Ecdysiasttt/com3505-iot/LA2/ProjectThing/src/config.h

// WiFi credentials
// #include <marvin-private.h>

// are you using an I2S microphone - comment this out if you want to use an analog mic and ADC input
// #define USE_I2S_MIC_INPUT

// I2S Microphone Settings

// Which channel is the I2S microphone on? I2S_CHANNEL_FMT_ONLY_LEFT or I2S_CHANNEL_FMT_ONLY_RIGHT
// #define I2S_MIC_CHANNEL I2S_CHANNEL_FMT_ONLY_LEFT
// #define I2S_MIC_CHANNEL I2S_CHANNEL_FMT_ONLY_RIGHT
/*
#define I2S_MIC_SERIAL_CLOCK GPIO_NUM_33
#define I2S_MIC_LEFT_RIGHT_CLOCK GPIO_NUM_26
#define I2S_MIC_SERIAL_DATA GPIO_NUM_25
*/

//#ifdef UNPHONE_SPIN
// #define I2S_MIC_SERIAL_CLOCK GPIO_NUM_32
//#else
//#endif


//#ifdef UNPHONE_SPIN
// #define I2S_MIC_SERIAL_DATA GPIO_NUM_33
//#else
//#endif

// old pinouts, changed to allow for e-ink feather
  // #define I2S_MIC_SERIAL_CLOCK GPIO_NUM_13
  // #define I2S_MIC_LEFT_RIGHT_CLOCK GPIO_NUM_15
  // #define I2S_MIC_SERIAL_DATA GPIO_NUM_21

// #define I2S_MIC_LEFT_RIGHT_CLOCK GPIO_NUM_13
// #define I2S_MIC_SERIAL_DATA GPIO_NUM_12
// #define I2S_MIC_SERIAL_CLOCK GPIO_NUM_27

// #define I2S_MIC_LEFT_RIGHT_CLOCK GPIO_NUM_16
// #define I2S_MIC_SERIAL_DATA GPIO_NUM_17
// #define I2S_MIC_SERIAL_CLOCK GPIO_NUM_21

// Analog Microphone Settings - ADC1_CHANNEL_7 is GPIO35
// #define ADC_MIC_CHANNEL ADC1_CHANNEL_7

// speaker settings
/*
#define I2S_SPEAKER_LEFT_RIGHT_CLOCK GPIO_NUM_12
#define I2S_SPEAKER_SERIAL_CLOCK GPIO_NUM_14
#define I2S_SPEAKER_SERIAL_DATA GPIO_NUM_27
// */
// #define I2S_SPEAKER_LEFT_RIGHT_CLOCK GPIO_NUM_21
// #define I2S_SPEAKER_SERIAL_CLOCK GPIO_NUM_21
// #define I2S_SPEAKER_SERIAL_DATA GPIO_NUM_17
// old pinouts, changed to allow for e-ink feather
  // #define I2S_SPEAKER_LEFT_RIGHT_CLOCK GPIO_NUM_12
  // #define I2S_SPEAKER_SERIAL_CLOCK GPIO_NUM_14
  // #define I2S_SPEAKER_SERIAL_DATA GPIO_NUM_27


// command recognition settings
// server access token
// #define COMMAND_RECOGNITION_ACCESS_KEY "FYNEKCN6DS7E63IT7DLS57O7X25VJSWZ"

// #define LED_KITCHEN_PIN GPIO_NUM_4
// #define LED_BEDROOM_PIN GPIO_NUM_26
// #define LED_TABLE_PIN GPIO_NUM_25

////////////////////////
// NEW SETTINGS
////////////////////////

// =============================== MIC ===============================
// Are you using an I2S microphone - comment this out if you want to use an analog mic and ADC input
#define USE_I2S_MIC_INPUT

// Pinouts
#define I2S_MIC_LEFT_RIGHT_CLOCK GPIO_NUM_16
#define I2S_MIC_SERIAL_DATA GPIO_NUM_17
#define I2S_MIC_SERIAL_CLOCK GPIO_NUM_21

// Analog Microphone Settings - ADC1_CHANNEL_7 is GPIO35
#define ADC_MIC_CHANNEL ADC1_CHANNEL_7

// Which channel is the I2S microphone on? I2S_CHANNEL_FMT_ONLY_LEFT or I2S_CHANNEL_FMT_ONLY_RIGHT
#define I2S_MIC_CHANNEL I2S_CHANNEL_FMT_ONLY_LEFT


// ============================= SPEAKER =============================
// == !!         NOT IN USE         !! ==
#define I2S_SPEAKER_LEFT_RIGHT_CLOCK -1
#define I2S_SPEAKER_SERIAL_CLOCK -1
#define I2S_SPEAKER_SERIAL_DATA -1

// ============================ INDICATOR ============================
// == !!     INSTEAD OF SPEAKER     !! ==
#define INDICATOR_LED_PIN GPIO_NUM_23

// ============================== E-INK ==============================
// Pinouts
#define EPD_DC GPIO_NUM_33
#define EPD_CS GPIO_NUM_15       
#define SRAM_CS GPIO_NUM_32 //SRAM Chip Select - communicates with onboard ram
// #define EPD_SPI &SPI
#define EPD_RESET GPIO_NUM_NC
#define EPD_BUSY GPIO_NUM_NC

// Colours
#define COLOR1 EPD_BLACK
#define COLOR2 EPD_RED
#define WHITE EPD_WHITE
#define BLACK EPD_BLACK


// ============================= WIT.AI ==============================
// Server access token
#define COMMAND_RECOGNITION_ACCESS_KEY "FYNEKCN6DS7E63IT7DLS57O7X25VJSWZ"
