Ecdysiasttt/com3505-iot/sketch/Ex08.cpp

// Ex08.cpp/.ino
// become a web client and send your email to our cloud server over HTTPS

#include "Thing.h"

// globals and utilities for connecting to COM3505 cloud server
WiFiClientSecure com3505Client; // the TLS web client
const char *com3505Addr   = "SERVER IP ADDRESS"; // server IP (see blackboard)
const int   com3505Port   = 9194;                // server port
const char* wifiSsid      = "CHANGE_ME";         // wifi AP for ESP to connect
const char* wifiPassword  = "CHANGE_ME_TOO";     // wifi PSK
const char* myEmail       = "AND_CHANGE_ME_AS_WELL@sheffield.ac.uk";// yr email

// x509 certificate for the server
const char* cert = \
  "-----BEGIN CERTIFICATE-----\n" \
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
  "PQ0ptJ0=" \
  "-----END CERTIFICATE-----\n";


void setup08() {
  setup07(); dln(startupDBG, "\nsetup08...");

  // a URI for the request
  String url;
  url = "/com3505-2024?email=";
  url += myEmail;
  url += "&mac=";
  url += MAC_ADDRESS;

  // conect to the uni network
  // (if your device is already provisioned you can use "WiFi.begin();" here)
  dbg(netDBG, "connecting to wifi...");
//  WiFi.begin();
  WiFi.begin(wifiSsid, wifiPassword);
  while(WiFi.status() != WL_CONNECTED) {
    delay(500);
    dbg(netDBG, ".");
  }

  dbg(netDBG, "wifi connected; IP address: ");
  dln(netDBG, WiFi.localIP());

  // now we'll try and talk to the "cloud" server; this is
  // in setup instead of loop so we don't send too much data to the server...
  //
  // first connect to the cloud server or reset after pause
  if(! cloudConnect()) {
    Serial.println("** OOOPS! no connection to server; restarting in 10 **");
    delay(10000);
    ESP.restart();
  }
    
  // send the request to the server
  cloudGet(url);

  // read all the lines of the reply from server and print to serial
  while(cloudAvailable()) dbg(netDBG, cloudRead());

  // job's a goodun
  dln(netDBG, "closing connection...");
  cloudStop();
} // setup08()

void loop08() {
  // serve pending web requests
  webServer.handleClient();
} // loop08()

// use WiFiClient class to create TCP connection to cloud
bool cloudConnect() {
  dbg(netDBG, "\nconnecting to ");
  dbg(netDBG, com3505Addr);
  dbg(netDBG, ":");
  dln(netDBG, com3505Port);

  // configure the TLS client for connection; ordinarily we would do
  // "setCACert(...)" but the server is using a self-signed certificate so the
  // CA chain doesn't exist; instead we just give the client certificate and
  // do "setInsecure" - the connection should still be encrypted, but more
  // vulnerable to a MitM attack
  com3505Client.setCertificate(cert); // client verification only
  // setInsecure doesn't exist in some of the Arduino core versions that we
  // may be using, so this is commented here; try uncommenting, and see the
  // notes: https://iot.unphone.net/#patch-the-core-for-ex08
  com3505Client.setInsecure(); // tell mbedTLS to ignore the CA chain

  // open the connection, or punt
  if(com3505Client.connect(com3505Addr, com3505Port)) {
    dln(netDBG, "connected to com3505 server; doing GET");
  } else {
    dbg(netDBG, com3505Addr);
    dln(netDBG, " - no com3505 server");
    return false;
  }
  return true;
} // cloudConnect()

// do a GET request on com3505Client
void cloudGet(String url) {
  dbg(netDBG, "requesting URL: ");
  dln(netDBG, url);
  com3505Client.print(
    String("GET ") + url + " HTTP/1.1\r\n" +
    "Host: " + com3505Addr + "\r\n" + "Connection: close\r\n\r\n"
  );
  unsigned long timeout = millis();
  while(com3505Client.available() == 0) {
    if(millis() - timeout > 5000) {
      dln(netDBG, ">>> client timeout !");
      cloudStop();
      return;
    }
  }
} // cloudGet()

// close cloud connection
void cloudStop() { com3505Client.stop(); }

// read a line from the cloud client after a request
String cloudRead() { return com3505Client.readStringUntil('\r'); }

// is there more to read from the response?
bool cloudAvailable() { return com3505Client.available(); }
