Ecdysiasttt/com3505-iot/LA2/ProjectThing/src/IntentProcessor.cpp

#include <Arduino.h>
#include "IntentProcessor.h"
#include "Speaker.h"
#include <RCSwitch.h>
#include "NetworkHelper.h"
// #include <dotstar_wing.h>

IntentProcessor::IntentProcessor(Speaker *speaker, IndicatorLight *indicator_light)
{
    m_speaker = speaker;
    m_indicator_light = indicator_light;
}

IntentResult IntentProcessor::turnOnDevice(const Intent &intent)
{
    Serial.printf(
      "turnOnDevice: confidence=%.f%%; device_name=%s; trait_value=%s; trait_confidence=%.f%%\n",
      100 * intent.intent_confidence, intent.device_name.c_str(),
      intent.trait_value.c_str(), 100 * intent.trait_confidence
    );

    if (intent.intent_confidence < 0.4)
    {
        Serial.printf("Only %.f%% certain on intent\n", 100 * intent.intent_confidence);
        return FAILED;
    }
    if (intent.device_name.empty())
    {
        Serial.println("No device found");
        return FAILED;
    }
    if (intent.device_confidence < 0.4)
    {
        Serial.printf("Only %.f%% certain on device\n", 100 * intent.device_confidence);
        return FAILED;
    }
    if (intent.trait_value.empty())
    {
        Serial.println("Can't work out the intent action");
        return FAILED;
    }
    if (intent.trait_confidence < 0.4)
    {
        Serial.printf("Only %.f%% certain on trait\n", 100 * intent.trait_confidence);
        return FAILED;
    }
    bool is_turn_on = intent.trait_value == "on";

    // global device name "lights"
    if (intent.device_name == "lights")
    {
        for (const auto &dev_pin : m_device_to_pin)
        {

            digitalWrite(dev_pin.second, is_turn_on);
        }
    }
    else if (intent.device_name == "plug") {
        RCSwitch transmitter = RCSwitch();
        transmitter.enableTransmit(GPIO_NUM_26);
        transmitter.setPulseLength(175);
        if (is_turn_on)
        {
            Serial.println("Turning on the plug");
            transmitter.send(1398067, 24);
        }
        else
        {
            Serial.println("Turning off the plug");
            transmitter.send(1398076, 24);
        }
    }
    else
    {
        // see if the device name is something we know about
        if (m_device_to_pin.find(intent.device_name) == m_device_to_pin.end())
        {
            Serial.printf("Don't recognise the device '%s'\n", intent.device_name.c_str());
            return FAILED;
        }
        digitalWrite(m_device_to_pin[intent.device_name], is_turn_on);
    }

    
    // success!
    return SUCCESS;
}

IntentResult IntentProcessor::tellJoke()
{
    m_speaker->playRandomJoke();
    return SILENT_SUCCESS;
}

IntentResult IntentProcessor::life()
{
    m_speaker->playLife();
    return SILENT_SUCCESS;
}

IntentResult IntentProcessor::update()
{
    // true to tell ota that it came from an intent
    // i.e. play noises for failure
    performOTAUpdate(true, m_speaker);
    return SILENT_SUCCESS;
}


IntentResult IntentProcessor::processIntent(const Intent &intent)
{
    Serial.printf(
      "processIntent: name=%s; confidence=%.f%%; trait_value=%s; trait_confidence=%.f%%\n",
      intent.intent_name.c_str(), 100 * intent.intent_confidence,
      intent.trait_value.c_str(), 100 * intent.trait_confidence
    );

    if (intent.text.empty())
    {
        Serial.println("No text recognised");
        return FAILED;
    }
    Serial.printf("I heard \"%s\"\n", intent.text.c_str());
    if (intent.intent_name.empty())
    {
        Serial.println("Can't work out what you want to do with the device...");
        return FAILED;
    }
    Serial.printf("Intent is %s\n", intent.intent_name.c_str());
    if (intent.intent_name == "turn_on_and_off")
    {
        return turnOnDevice(intent);
    }
    if (intent.intent_name == "tell_joke")
    {
        return tellJoke();
    }
    if (intent.intent_name == "life")
    {
        return life();
    }
    if (intent.intent_name == "get_update")
    {
        return update();
    }

    return FAILED;
}

void IntentProcessor::addDevice(const std::string &name, int gpio_pin)
{
    m_device_to_pin.insert(std::make_pair(name, gpio_pin));
    pinMode(gpio_pin, OUTPUT);
}
