Ecdysiasttt/com3505-iot/LA2/ProjectThing/src/IntentProcessor.h

#ifndef _intent_processor_h_
#define _intent_processor_h_

#include <map>
#include "WitAiChunkedUploader.h"

class Speaker;
class IndicatorLight;

enum IntentResult
{
    FAILED,
    SUCCESS,
    SILENT_SUCCESS // success but don't play ok sound
};

class IntentProcessor
{
private:
    std::map<std::string, int> m_device_to_pin;
    IntentResult turnOnDevice(const Intent &intent);
    // IntentResult changeColour(const Intent &intent);
    IntentResult tellJoke();
    IntentResult life();
    IntentResult update();

    IndicatorLight *m_indicator_light;

    Speaker *m_speaker;

public:
    IntentProcessor(Speaker *speaker, IndicatorLight *indicator_light);
    void addDevice(const std::string &name, int gpio_pin);
    IntentResult processIntent(const Intent &intent);
};

#endif
