Ecdysiasttt/com3505-iot/(commit log)

2024-03-22 added circuit photos
2024-04-17 fixed AP issues when initial wifi connection unsuccessful.
    [DisplayHelper.cpp, IntentProcessor.cpp, NetworkHelper.cpp]
